josh-l-wang/vault35-katana/plate/vault35-katana plate_1u.dxf

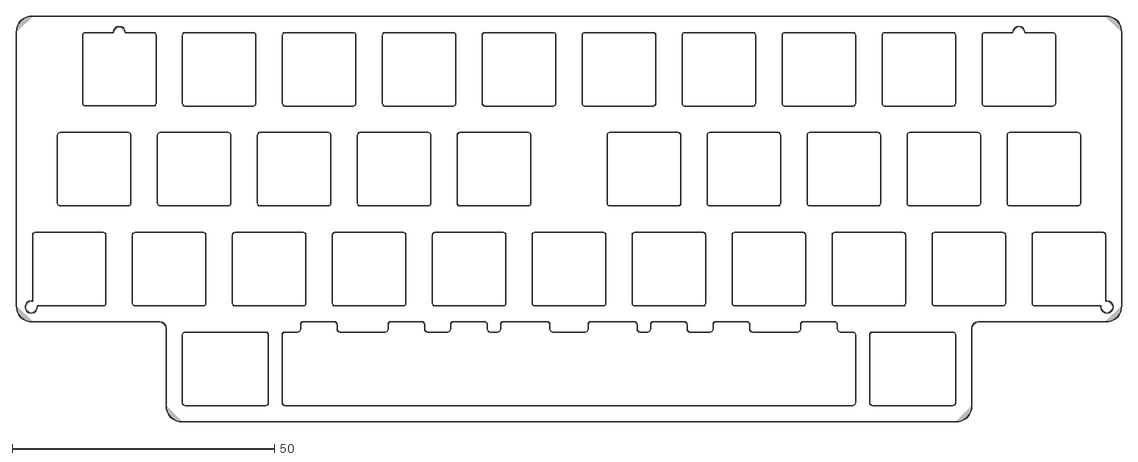
[picture p6: CAD file, 2024-01-09]
plate/vault35-katana plate_1u.dxf
210.6 x 77.3
