josh-l-wang/vault35-katana/plate/vault35-katana plate_universal.dxf

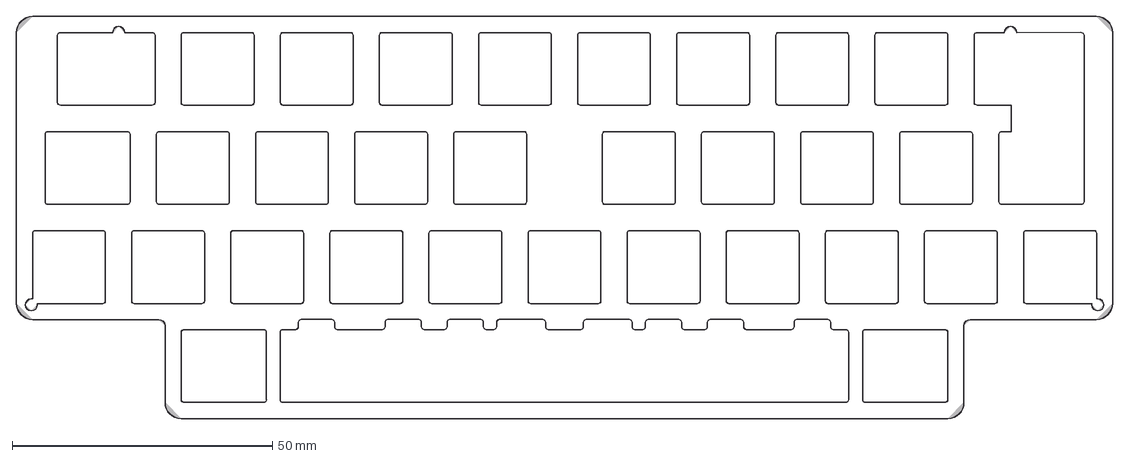
[picture p7: CAD file, 2024-01-09]
plate/vault35-katana plate_universal.dxf
210.6 x 77.3 mm
