josh-l-wang/vault35-katana/KiCAD/vault35-katana-sk6812/vault35-katana-sk6812.kicad_sch

## KiCad design KiCAD/vault35-katana-sk6812/vault35-katana-sk6812.kicad_sch (2024-01-09)

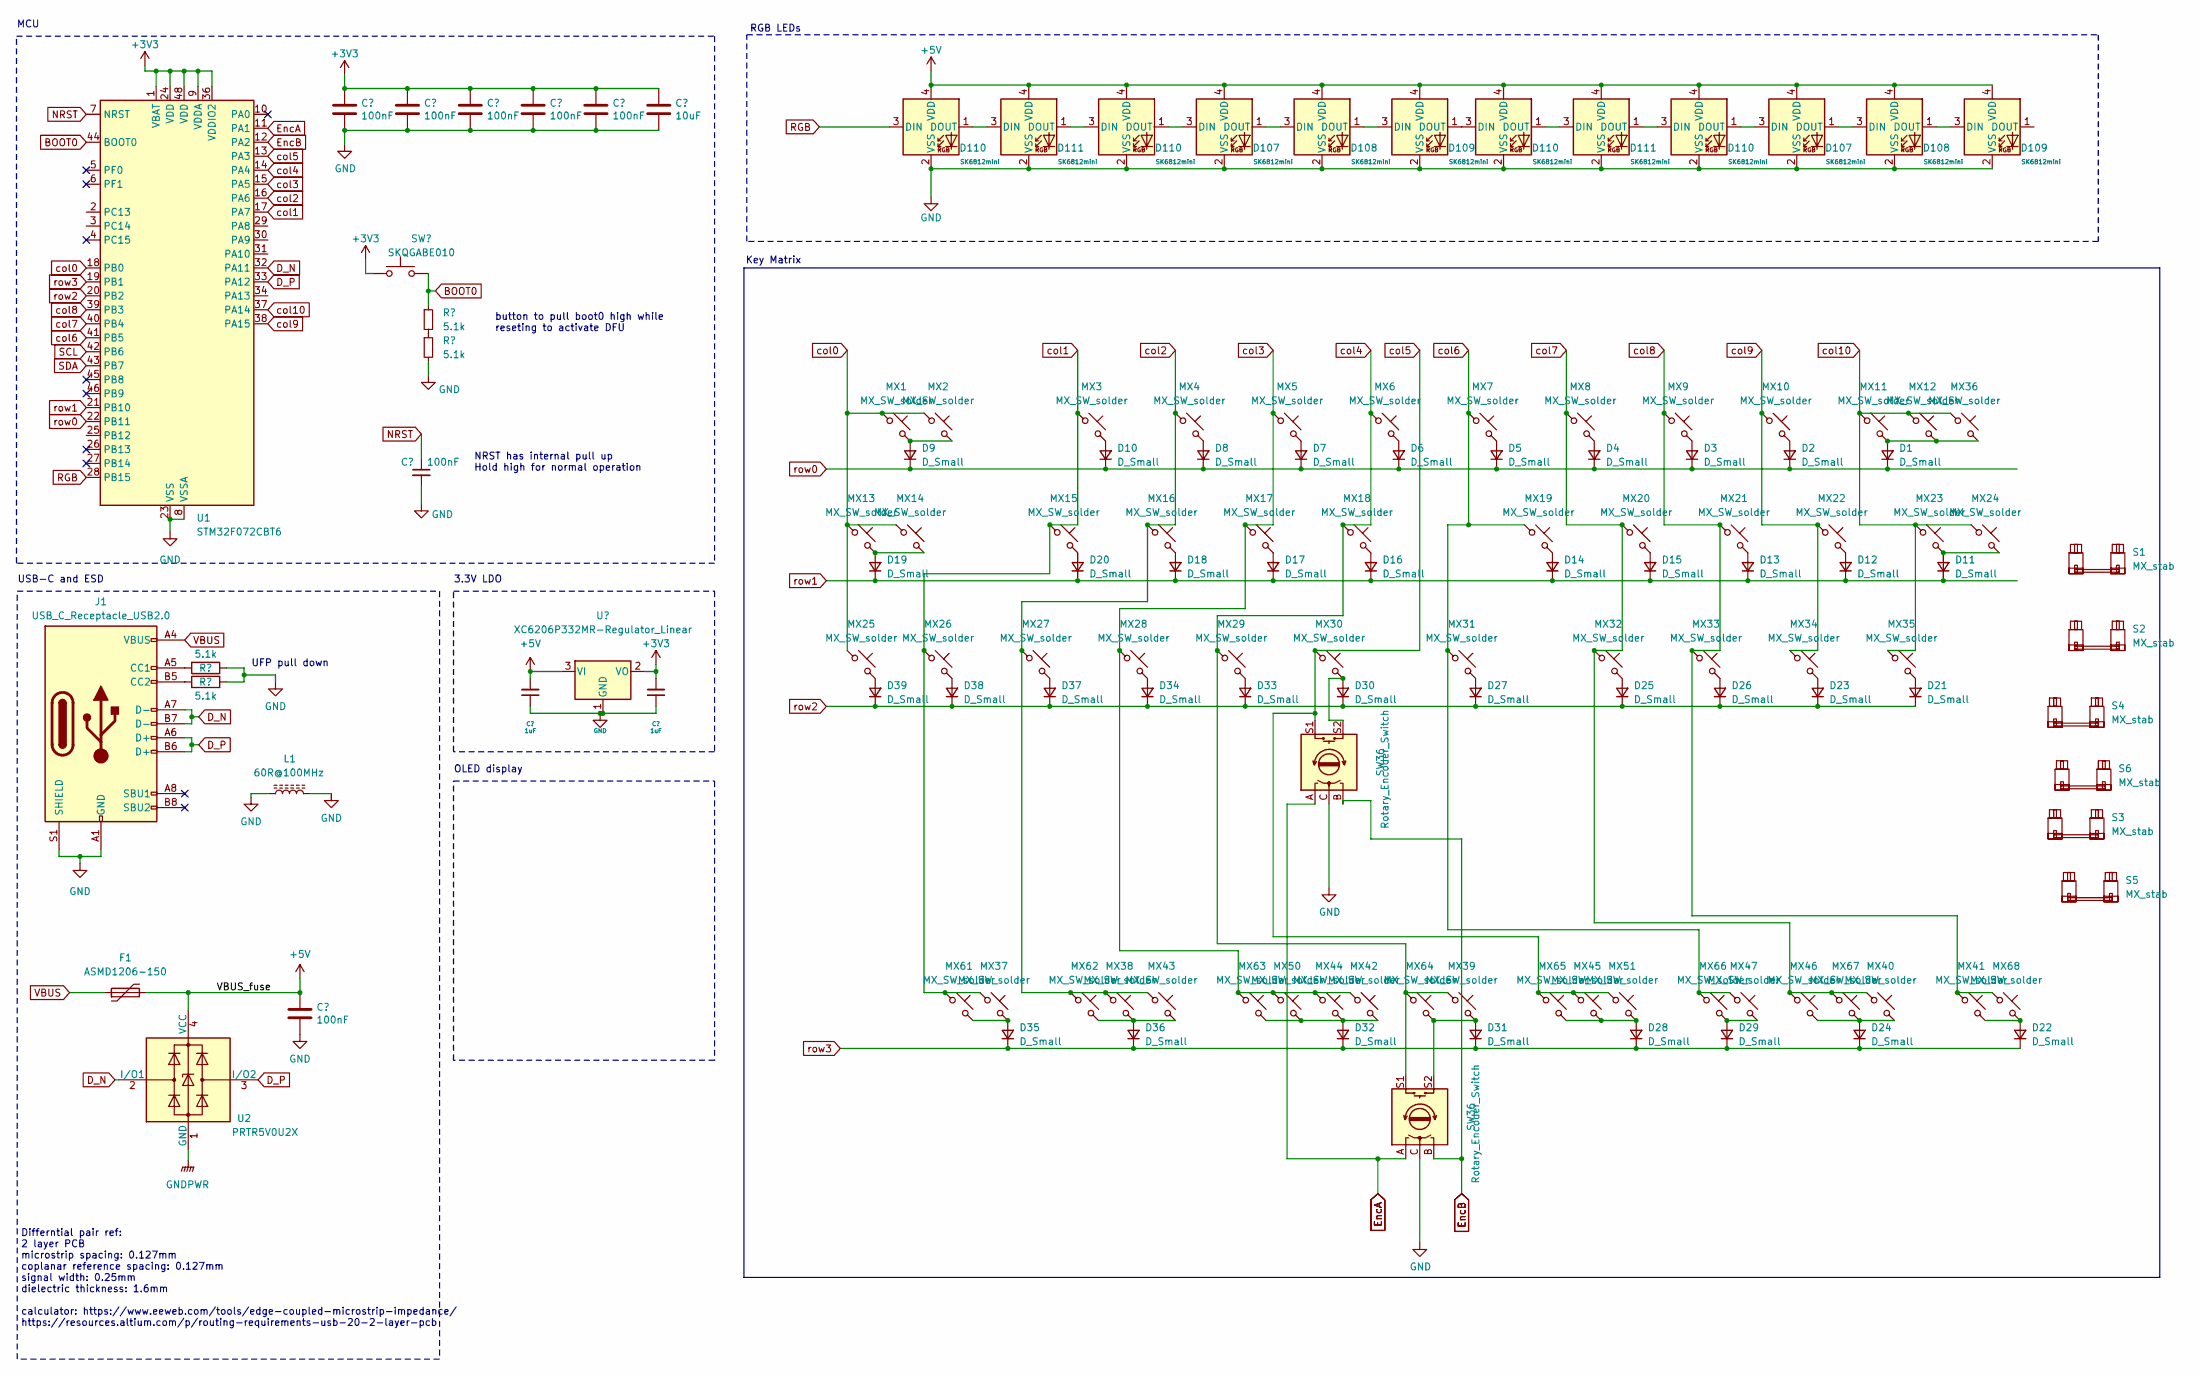
[picture p8: schematic vault35-katana-sk6812.kicad_sch]

Parts:
C1, C2, C3, C4, C5, C7, C8: 100nF; C_0402_1005Metric; LCSC C307331
C6: 10uF; C_0603_1608Metric; LCSC C96446
C11, C12: 1uF; C_0402_1005Metric; LCSC C52923
D1, D2, D3, D4, D5, D6, D7, D8, D9, D10, D11, D12, D13, D14, D15, D16, D17, D18, D19, D20, D21, D22, D23, D24, D25, D26, D27, D28, D29, D30, D31, D32, D33, D34, D35, D36, D37, D38, D39: D_Small; D_SOD-123-hidden-ref; LCSC C81598
D107: SK6812mini; LED_SK6812MINI_PLCC4_3.5x3.5mm_P1.75mm; JlcRotOffset 180
D108, D109, D111: SK6812mini; LED_SK6812MINI_PLCC4_3.5x3.5mm_P1.75mm; JlcRotOffset 14
D110: SK6812mini; LED_SK6812MINI_PLCC4_3.5x3.5mm_P1.75mm; JlcRotOffset 194
F1: ASMD1206-150; Fuse_1206_3216Metric; LCSC C135341
J1: USB_C_Receptacle_USB2.0; USB_C_Receptacle_HRO_TYPE-C-31-M-12; JlcRotOffset 180
L1: 60R@100MHz; L_1206_3216Metric; Manufacturer Part No MLB3216-600P4A(f); LCSC C33600
MX1, MX3, MX4, MX5, MX6, MX7, MX8, MX9, MX10, MX12, MX13, MX15, MX16, MX17, MX18, MX19, MX20, MX21, MX22, MX24, MX25, MX26, MX27, MX28, MX29, MX30, MX31, MX32, MX33, MX34, MX35, MX36, MX39, MX50, MX51, MX61, MX62, MX63, MX64, MX65, MX66, MX67, MX68: MX_SW_solder; SW_MX_1u
MX2, MX11, MX42, MX47: MX_SW_solder; SW_MX_1.5u
MX14, MX23, MX37, MX38, MX40, MX41, MX43, MX46: MX_SW_solder; SW_MX_1.25u
MX44, MX45: MX_SW_solder; SW_MX_1.75u
R1, R2, R3: 5.1k; R_0402_1005Metric; LCSC C25905
S1: MX_stab; STAB_MX_ISO
S2, S5, S6: MX_stab; STAB_MX_3u
S3, S4: MX_stab; STAB_MX_2u
SW36: Rotary_Encoder_Switch; RotaryEncoder_Alps_EC11E-Switch_Vertical_H20mm
SW37: SKQGABE010; SW_SPST_SKQG_WithoutStem; LCSC C318884
U1: STM32F072CBT6; LQFP-48_7x7mm_P0.5mm; JlcRotOffset 90
U2: PRTR5V0U2X; SOT-143; LCSC C2827688
U3: XC6206P332MR-Regulator_Linear; SOT-23; LCSC C5446

Connections:
+3V3: C1.1, C2.1, C3.1, C4.1, C5.1, C6.1, C12.2, SW37.1, U1.1 (VBAT), U1.9 (VDDA), U1.24 (VDD), U1.36 (VDDIO2), U1.48 (VDD), U3.2 (VO)
+5V: C8.1, C11.2, D107.4 (VDD), D108.4 (VDD), D109.4 (VDD), D110.4 (VDD), D111.4 (VDD), F1.2, U2.4 (VCC), U3.3 (VI)
BOOT0: R3.1, SW37.2, U1.44 (BOOT0)
D_N: J1.A7 (D-), J1.B7 (D-), U1.32 (PA11), U2.2 (I/O1)
D_P: J1.A6 (D+), J1.B6 (D+), U1.33 (PA12), U2.3 (I/O2)
EncA: SW36.A, U1.11 (PA1)
EncB: SW36.B, U1.12 (PA2)
GND: C1.2, C2.2, C3.2, C4.2, C5.2, C6.2, C7.2, C8.2, C11.1, C12.1, D107.2 (VSS), D108.2 (VSS), D109.2 (VSS), D110.2 (VSS), D111.2 (VSS), J1.A1 (GND), J1.A12 (GND), J1.B1 (GND), J1.B12 (GND), J1.S1 (SHIELD), L1.1, L1.2, R1.1, R2.1, R3.2, SW36.C, U1.8 (VSSA), U1.23 (VSS), U1.35 (VSS), U1.47 (VSS), U3.1 (GND)
GNDPWR: U2.1 (GND)
NRST: C7.1, U1.7 (NRST)
unnamed: D1.2 (A), MX11.2, MX12.2, MX36.2
unnamed: D2.2 (A), MX10.2
unnamed: D3.2 (A), MX9.2
unnamed: D4.2 (A), MX8.2
unnamed: D5.2 (A), MX7.2
unnamed: D6.2 (A), MX6.2
unnamed: D7.2 (A), MX5.2
unnamed: D8.2 (A), MX4.2
unnamed: D9.2 (A), MX1.2, MX2.2
unnamed: D10.2 (A), MX3.2
unnamed: D11.2 (A), MX23.2, MX24.2
unnamed: D12.2 (A), MX22.2
unnamed: D13.2 (A), MX21.2
unnamed: D14.2 (A), MX19.2
unnamed: D15.2 (A), MX20.2
unnamed: D16.2 (A), MX18.2
unnamed: D17.2 (A), MX17.2
unnamed: D18.2 (A), MX16.2
unnamed: D19.2 (A), MX13.2, MX14.2
unnamed: D20.2 (A), MX15.2
unnamed: D21.2 (A), MX35.2
unnamed: D22.2 (A), MX41.2, MX68.2
unnamed: D23.2 (A), MX34.2
unnamed: D24.2 (A), MX40.2, MX46.2, MX67.2
unnamed: D25.2 (A), MX32.2
unnamed: D26.2 (A), MX33.2
unnamed: D27.2 (A), MX31.2
unnamed: D28.2 (A), MX45.2, MX51.2, MX65.2
unnamed: D29.2 (A), MX47.2, MX66.2
unnamed: D30.2 (A), MX30.2, SW36.S2
unnamed: D31.2 (A), MX39.2, MX64.2, SW36.S2
unnamed: D32.2 (A), MX42.2, MX44.2, MX50.2, MX63.2
unnamed: D33.2 (A), MX29.2
unnamed: D34.2 (A), MX28.2
unnamed: D35.2 (A), MX37.2, MX61.2
unnamed: D36.2 (A), MX38.2, MX43.2, MX62.2
unnamed: D37.2 (A), MX27.2
unnamed: D38.2 (A), MX26.2
unnamed: D39.2 (A), MX25.2
unnamed: D107.1 (DOUT), D108.3 (DIN)
unnamed: D107.3 (DIN), D110.1 (DOUT)
unnamed: D108.1 (DOUT), D109.3 (DIN)
unnamed: D109.1 (DOUT), D110.3 (DIN)
unnamed: D110.1 (DOUT), D111.3 (DIN)
unnamed: D110.3 (DIN), D111.1 (DOUT)
unnamed: J1.A5 (CC1), R1.2
unnamed: J1.B5 (CC2), R2.2
unnamed: R3.1, R3.2
RGB: D110.3 (DIN), U1.28 (PB15)
SCL: U1.42 (PB6)
SDA: U1.43 (PB7)
VBUS: F1.1, J1.A4 (VBUS), J1.A9 (VBUS), J1.B4 (VBUS), J1.B9 (VBUS)
col0: MX1.1, MX2.1, MX13.1, MX14.1, MX25.1, U1.18 (PB0)
col1: MX3.1, MX15.1, MX26.1, MX37.1, MX61.1, U1.17 (PA7)
col2: MX4.1, MX16.1, MX27.1, MX38.1, MX43.1, MX62.1, U1.16 (PA6)
col3: MX5.1, MX17.1, MX28.1, MX42.1, MX44.1, MX50.1, MX63.1, U1.15 (PA5)
col4: MX6.1, MX18.1, MX29.1, MX39.1, MX64.1, SW36.S1, U1.14 (PA4)
col5: MX30.1, MX45.1, MX51.1, MX65.1, SW36.S1, U1.13 (PA3)
col6: MX7.1, MX19.1, MX31.1, MX47.1, MX66.1, U1.41 (PB5)
col7: MX8.1, MX20.1, MX32.1, MX40.1, MX46.1, MX67.1, U1.40 (PB4)
col8: MX9.1, MX21.1, MX33.1, MX41.1, MX68.1, U1.39 (PB3)
col9: MX10.1, MX22.1, MX34.1, U1.38 (PA15)
col10: MX11.1, MX12.1, MX23.1, MX24.1, MX35.1, MX36.1, U1.37 (PA14)
row0: D1.1 (K), D2.1 (K), D3.1 (K), D4.1 (K), D5.1 (K), D6.1 (K), D7.1 (K), D8.1 (K), D9.1 (K), D10.1 (K), U1.22 (PB11)
row1: D11.1 (K), D12.1 (K), D13.1 (K), D14.1 (K), D15.1 (K), D16.1 (K), D17.1 (K), D18.1 (K), D19.1 (K), D20.1 (K), U1.21 (PB10)
row2: D21.1 (K), D23.1 (K), D25.1 (K), D26.1 (K), D27.1 (K), D30.1 (K), D33.1 (K), D34.1 (K), D37.1 (K), D38.1 (K), D39.1 (K), U1.20 (PB2)
row3: D22.1 (K), D24.1 (K), D28.1 (K), D29.1 (K), D31.1 (K), D32.1 (K), D35.1 (K), D36.1 (K), U1.19 (PB1)

Notes on the sheet:
button to pull boot0 high while reseting to activate DFU
UFP pull down
MCU
RGB LEDs
3.3V LDO
USB-C and ESD
OLED display
NRST has internal pull up Hold high for normal operation
Differntial pair ref: 2 layer PCB microstrip spacing: 0.127mm coplanar reference spacing: 0.127mm signal width: 0.25mm dielectric thickness: 1.6mm calculator: https://www.eeweb.com/tools/edge-coupled-microstrip-impedance/ https://resources.altium.com/p/routing-requirements-usb-20-2-layer-pcb
Key Matrix
