josh-l-wang/vault35-katana/(commit log)

2023-10-28 v0.1 pcb files uploaded
    [bom.csv, designators.csv, key_matrix.kicad_sch, leds.kicad_sch, positions.csv, rgb.kicad_sch, vault35-katana plate_1u.kicad_pcb, vault35-katana plate_universal.kicad_pcb]
2023-10-29 updated plate images
2023-11-21 elecrow production files
    [vault35-katana-sk6812.csv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]
2024-01-09 update plates
    [vault35-katana plate_1u.dxf, vault35-katana plate_universal.dxf, vault35-katana plate_universal.kicad_pcb, vault35-katana-sk6812.csv, vault35-katana-sk6812.kicad_sch, vault35_katana_plate_1u.dxf, vault35_katana_plate_universal.dxf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]
2024-01-09 clean up footprints and firmware
